pbharrin/dodo-bot/simulation/training/README.md

# Learned stand / step-in-place policy (stage 1)

Trains a 50 Hz joint-position policy for the [v5 model](../models/build_model_v5.py) with MuJoCo Playground, Brax PPO and MJX-Warp. Each episode is either **stand** (25%) or **step in place** following a two-foot gait clock (75%). The base-velocity command is zero, so a good policy marches on the spot without drifting and recovers from pushes.

Stage 1 is meant to replace the quasi-static two-foot-to-one-foot work. Stepping in place includes weight transfer and single support, but done dynamically.

| File | Purpose |
| --- | --- |
| `dodo_env.py` | `DodoStepInPlace` environment, rewards, observations, domain randomization |
| `train_ppo.py` | PPO training, checkpoints, final evaluation and videos |
| `evaluate.py` | Reload a run, run deterministic rollouts, write `eval.json` and videos |
| `render_backend.py` | Picks EGL for headless video, or falls back to no rendering if the GL libraries are missing |
| `replay_mujoco.py` | Replays a policy in plain C MuJoCo under harsher conditions: full solver, smaller timestep, latency, lower torque limits |
| `warm_start.py` | Starts stage 2 from the stage-1 policy, adapting the command inputs |
| `test_dodo_env.py` | Pre-flight checks: model mass/geometry, MJX vs MuJoCo, passive standing, gait clock, randomization |

## Status

- **CPU-validated (JAX backend, Apple M2):** all tests pass, the full train → save → evaluate → render pipeline runs, and the zero-action robot stands for 4 s. See "Validation" below for a short CPU learning-signal run.
- **GPU-validated (MJX-Warp, g5.xlarge A10G, 2026-11-02):** all 6 tests (the 7th, a config check, was added afterwards) pass with `DODO_TEST_IMPL=warp`. A 10M-step trial ran at about 35k steps/s. Eval: 100% survival over 20 s with pushes in all 64 episodes, but stepping contact match 0.61 (the never-lift baseline is 0.60) and peak foot height about 1 cm. It learned to stand, not to step.
- **Stage 1 trained (2026-11-02):** 150M steps on the g5.xlarge in 41 min. The policy stands and steps in place with 4 cm foot clearance and survives every evaluation episode with pushes. See "Stage 1 result" below. Not yet checked: C MuJoCo replay, rope compliance, measured actuator limits.
- **Stage 2 trained (2026-11-02):** `stage2_walk` walks, turns and sidesteps on command with 100% survival with pushes, but with a favoured-leg gait. **`stage2_sym`** (fine-tuned with a symmetry reward) fixes that and is the current best policy. See "Stage 2: walking" below.
- **Stage 2b trained (2026-11-02): `stage2_smooth` is the current best policy.** A 6 Hz action low-pass filter cuts knee/ankle torque saturation about 40× with equal or better walking. It falls once in 24 replay episodes at 40 ms latency (`stage2_sym`: none). See "Stage 2b".
- **C MuJoCo replay passed (2026-11-02):** `stage2_sym` keeps 100% survival in plain C MuJoCo with the full solver, a 2 ms timestep, up to 40 ms latency and torque limits down to 6 Nm. See "C MuJoCo replay check".
- **Torque measurement corrected (2026-11-02):** the stage-1 and `stage2_walk` torque tables below sampled torque at the end of each 20 ms control step and miss brief PD-servo spikes right after each new target. p95 and RMS there are fine; their max / saturation numbers understate the peaks. See "Torque spikes from position-target steps".

## Stage 1 result (2026-11-02)

Run `stage1_v5`: 150M env steps, 8192 envs, MJX-Warp on a g5.xlarge (A10G), domain randomization on, default config. Training took 2434 s (about 62k steps/s) plus 46 s of JIT. The run directory isn't in git (`simulation/results/local/` is ignored).

**Learning curve.** Episodes reached the full 20 s by 10M steps. Contact match rose through about 45M steps and then plateaued at about 0.86. Reward plateaued at about 117. More steps at this config are unlikely to help.

| Steps | Eval reward | Episode length | Contact match (all episodes) |
| ---: | ---: | ---: | ---: |
| 0 | -1.0 | 45 | 0.52 |
| 10.8M | 99.8 | 1000 | 0.74 |
| 21.6M | 111.5 | 1000 | 0.82 |
| 43.3M | 115.5 | 1000 | 0.85 |
| 86.5M | 117.0 | 1000 | 0.87 |
| 151.4M | 116.4 | 993 | 0.87 |

**Evaluation.** 64 deterministic 20 s episodes on the nominal model with sensor noise, pushes and random action delay. The figures are from `evaluate.py --impl jax` on a Mac; the GPU evaluation at the end of training gave the same picture (stepping contact match 0.84, foot height 4.2 cm, peak torque 10.0 Nm).

| | Stepping (47 episodes) | Standing (17 episodes) |
| --- | ---: | ---: |
| Survival over 20 s | 100% | 100% |
| Contact match (never-lift baseline 0.60) | 0.84 | 1.00 |
| Mean peak foot height (target 3–5 cm) | 4.2 cm | 0.9 cm |
| Base drift over 20 s | 20 cm | 1 cm |
| Peak joint torque | 9.3 Nm | 4.7 Nm |

**Joint torque while stepping** (N m, steady stepping, 38.8k control steps outside the 1 s after a push):

| Joint | Left p95 | Left p99 | Left max | Left RMS | Right p95 | Right p99 | Right max | Right RMS |
| --- | ---: | ---: | ---: | ---: | ---: | ---: | ---: | ---: |
| hip yaw | 1.5 | 1.9 | 2.8 | 0.7 | 1.0 | 1.4 | 2.4 | 0.5 |
| hip roll | 4.8 | 5.7 | 7.0 | 2.4 | 4.5 | 5.1 | 8.6 | 2.5 |
| hip pitch | 1.4 | 2.3 | 3.7 | 0.7 | 1.5 | 2.0 | 3.6 | 0.8 |
| knee pitch | 4.8 | 5.9 | 8.0 | 2.5 | 3.2 | 4.1 | 5.8 | 1.8 |
| ankle pitch | 3.8 | 6.4 | 7.8 | 1.7 | 2.0 | 2.8 | 4.3 | 0.9 |

Findings:

- **No joint ever hits the 10 Nm limit** (0% of control steps saturated, stepping or standing). *Correction:* this table samples the end of each control step. Brief servo spikes in the first substep after a new target do reach 10 Nm; see "Torque spikes from position-target steps".
- **The torque comes from stepping itself, not from pushes.** The push-recovery table is nearly identical to the one above; it adds only the single highest peak (left ankle, 9.3 Nm). Single support needs it: hip roll, knee and ankle reach p95 of 4–5 Nm and p99 of up to 6.4 Nm on every gait cycle, with short peaks of 7–9 Nm. That matches the 6.7 Nm static hip-roll moment of the 6.84 kg model.
- **RMS is at most 2.5 Nm** (hip roll and knee). This is the number to compare with the measured continuous rating; peaks must fit the measured short-term rating (about 9 Nm ≈ 14 A at the plan's 0.625 Nm/A estimate).
- **The gait is asymmetric:** the left knee and ankle carry noticeably more torque than the right (p95 4.8 vs 3.2 Nm and 3.8 vs 2.0 Nm). No symmetry term is in the reward. Worth watching in videos and possibly penalizing.
- **Standing is cheap:** p95 below 2 Nm on every joint.
- **Drift of 20 cm in 20 s** while stepping: slow wandering rather than stepping on the spot. A candidate for a stronger base-velocity penalty in a later run.

Hardware implication for milestone 2: an actuator module that holds about 2.5 Nm continuous and about 9–10 Nm for short bursts covers this policy, with the masses currently estimated in the model. If the bench shows less, retrain with the measured limit; the policy will trade gait aggressiveness and push recovery for it.

## Stage 2: walking

The robot follows a base-velocity command: forward/back speed, sideways speed and yaw rate in the body frame, resampled every 10 s. `--task walk` applies `dodo_env.WALK_OVERRIDES`:

| Setting | Stage 1 | Stage 2 |
| --- | --- | --- |
| `lin_vel_x` (m/s) | 0 | −0.1 to 0.3 |
| `lin_vel_y` (m/s) | 0 | −0.1 to 0.1 |
| `ang_vel_yaw` (rad/s) | 0 | −0.5 to 0.5 |
| `zero_command_probability` (stepping segments told to step in place) | — | 0.2 |
| `stand_probability` | 0.25 | 0.15 |

Stand episodes always get a zero command. The speed ranges are ESTIMATES: 0.3 m/s is a slow walk for a 0.33 m leg (Froude number about 0.03). Gait clock, randomization and pushes are unchanged from stage 1. Since `stage2_walk` was trained, `WALK_OVERRIDES` also includes the symmetry reward (`reward_config.scales.symmetry=-4.0`; see "Left/right symmetry" below).

Run on the GPU machine, starting from the stage-1 policy:

```bash
python simulation/training/train_ppo.py --run-name stage2_walk --task walk \
    --warm-start simulation/results/local/train/stage1_v5 2>&1 | tee stage2.log
```

**Why `--warm-start` and not `--restore`:** stage 1 only ever saw a zero command, so its observation normalizer stores a std of 1e-6 for the command inputs. Restoring it unchanged would feed a 0.3 m/s command to the network as about 300,000. Because the normalizer averages over all 150M past steps, it would take a long time to correct. `warm_start.py` sets the command normalization to the stage-2 command distribution and zeroes the first-layer weights on the command inputs. Those weights never got any gradient in stage 1. The warm-started policy therefore starts out acting exactly like the stage-1 policy, whatever the command, and learns to use the command from there. (Checked: identical actions for zero and non-zero commands; the first eval of a smoke run already has stepping contact match 0.82, against 0.52 from scratch.) Only inputs that never varied in the source run are adapted. Warm-starting from a run that already saw commands, such as `stage2_walk`, keeps the policy exactly as trained (the script prints `adapted command inputs [False, False, False]`). Use `--restore` only to resume a run of the same task with the same rewards.

What to look for in `eval.json` (now also reported by `evaluate.py` for any run):

- `velocity_tracking.moving`: `lin_vel_error_mps` and `yaw_rate_error_radps`, plus commanded vs. actual mean speed. A policy that ignores the command shows actual speed near 0 and an error close to the commanded speed.
- `velocity_tracking.zero_command`: whether it still steps in place without wandering.
- Survival, contact match and the torque tables as in stage 1. Faster walking may raise knee and hip torque.

If it learns to stand or shuffle instead of walking, the usual fixes are a larger `tracking_lin_vel` scale or a narrower speed range to start, e.g. `--env-override lin_vel_x=[0,0.15]`.

### Stage 2 result: `stage2_walk` (2026-11-02)

150M steps, warm-started from `stage1_v5`, MJX-Warp on the g5.xlarge (about 40 min), no symmetry reward. GPU evaluation at the end of training: 64 episodes of 20 s with noise, pushes and action delay.

| | Stepping (52 episodes) | Standing (12 episodes) |
| --- | ---: | ---: |
| Survival over 20 s | 100% | 100% |
| Commanded / actual mean speed while moving | 0.146 / 0.132 m/s | — |
| Speed error while moving (ignoring the command would be about 0.15) | 0.067 m/s | — |
| Yaw-rate error while moving (commands up to ±0.5 rad/s) | 0.058 rad/s | — |
| Mean speed with zero command (includes step-to-step sway) | 0.052 m/s | 0.010 m/s |
| Contact match | 0.84 | 1.00 |
| Mean peak foot height | 4.2 cm | 0.9 cm |
| Peak joint torque | 10.0 Nm | 5.3 Nm |

Walking reaches about 90% of the commanded speed and tracks yaw well. The legs never cross in the videos.

**Torque while walking** (steady stepping, N m, compared with stage 1; end-of-control-step samples, see the correction in "Status"): p95 and RMS barely change. Hip roll p99 rises to 6.3 Nm (stage 1: 5.7), about the static single-support moment. The limit is touched only in rare spikes: left ankle 0.01% of control steps, right hip roll once. RMS stays at or below 2.5 Nm on every joint. The actuator target is unchanged from stage 1: about 2.5 Nm continuous, about 6.5 Nm p99 and brief 10 Nm peaks.

| Joint | Left p95 | Left p99 | Left max | Right p95 | Right p99 | Right max | RMS (L / R) |
| --- | ---: | ---: | ---: | ---: | ---: | ---: | ---: |
| hip yaw | 1.5 | 2.0 | 3.1 | 1.3 | 1.7 | 2.7 | 0.7 / 0.6 |
| hip roll | 4.9 | 6.3 | 8.9 | 4.8 | 5.5 | 10.0 | 2.4 / 2.5 |
| hip pitch | 1.7 | 2.3 | 4.6 | 1.7 | 2.2 | 3.4 | 0.8 / 0.9 |
| knee pitch | 4.1 | 5.0 | 6.9 | 3.5 | 4.6 | 7.5 | 2.3 / 1.9 |
| ankle pitch | 4.4 | 6.6 | 10.0 | 2.3 | 3.1 | 5.2 | 1.9 / 1.1 |

### Left/right symmetry

In the videos the left leg moves as if injured, without the right leg's range of motion. The model is exactly mirror-symmetric (checked: body positions, masses, inertias, joint axes, ranges and actuators; CoM on the midline), so this is a learned habit. Nothing in the stage-1 or stage-2 reward asked for symmetry, so the policy settled into a favoured-leg gait in stage 1, and stage 2 inherited it.

`evaluate.py` now measures this. Stepping episodes, re-evaluated with `--impl jax` (ROM = p95 − p5 joint angle in rad; mirror error = RMS of `right(t) − M·left(t − T/2)` and vice versa, where `M` flips hip yaw and roll):

| Joint | `stage1_v5` ROM L / R | `stage2_walk` ROM L / R | `stage2_walk` torque p95 L / R (N m) | `stage2_walk` mirror error (rad) |
| --- | ---: | ---: | ---: | ---: |
| hip yaw | 0.149 / 0.091 | 0.194 / 0.135 | 1.5 / 1.3 | 0.10 |
| hip roll | 0.086 / 0.146 | 0.119 / 0.144 | 4.9 / 4.8 | 0.05 |
| hip pitch | 0.202 / 0.177 | 0.252 / 0.262 | 1.7 / 1.7 | 0.10 |
| knee pitch | 0.402 / 0.354 | 0.419 / 0.401 | 4.1 / 3.5 | 0.11 |
| ankle pitch | 0.226 / 0.325 | 0.349 / 0.410 | 4.4 / 2.4 | 0.21 |

The left ankle uses 15–30% less range than the right while carrying nearly twice the torque, and its mirror error (about 0.2 rad, 11°) is twice that of any other joint. The left hip roll also moves less.

**Symmetry reward.** In a symmetric gait each leg repeats what the other did half a gait cycle earlier, mirrored. The env keeps the last 32 control steps of joint angles and, in stepping episodes, penalizes the squared error `|q_R(t) − M q_L(t − T/2)|² + |q_L(t) − M q_R(t − T/2)|²`, where T is taken from the gait clock. Pitch joints always count. Hip yaw and roll are weighted by `exp(−(v_y/0.03)² − (ω_z/0.1)²)`, because sideways and turning commands legitimately need asymmetric hip motion. Scale −4.0, about 5% of the per-step reward for the current gait. The penalty isn't in the critic's observation; the history is left out so the observation layout stays compatible with existing runs.

Fine-tune from `stage2_walk` on the g5 (about 40 min); this produced `stage2_sym`:

```bash
python simulation/training/train_ppo.py --run-name stage2_sym --task walk \
    --warm-start simulation/results/local/train/stage2_walk 2>&1 | tee stage2_sym.log
```

If a habit like this doesn't train out, retrain stages 1 and 2 from scratch with the symmetry reward on from the start (`--env-override reward_config.scales.symmetry=-4.0` for stage 1). A policy that is mirror-symmetric by construction is the stronger fallback.

### Stage 2 result: `stage2_sym` (2026-11-02)

150M steps warm-started from `stage2_walk` with the symmetry reward (scale −4.0). Evaluated on the Mac with `evaluate.py --impl jax` (64 episodes). In the videos the left leg no longer looks injured.

Mirror error (RMS rad) and ROM ratio, `stage2_walk` → `stage2_sym`:

| Joint | Mirror error, all stepping | Mirror error, straight commands | ROM ratio L/R |
| --- | --- | --- | --- |
| ankle pitch | 0.213 → **0.048** | 0.190 → 0.039 | 0.85 → 0.95 |
| knee pitch | 0.107 → 0.047 | 0.094 → 0.045 | 1.04 → 0.93 |
| hip pitch | 0.099 → 0.037 | 0.080 → 0.032 | 0.96 → 1.02 |
| hip roll | 0.049 → 0.045 | 0.035 → 0.027 | 0.82 → 0.92 |
| hip yaw | 0.101 → 0.087 | 0.073 → 0.038 | 1.44 → 1.50 |

Walking is unaffected or slightly better: 100% survival (64/64), stepping contact match 0.84, commanded / actual speed 0.151 / 0.147 m/s (98%), speed error 0.070 m/s, yaw-rate error 0.062 rad/s, peak foot height 4.3 cm.

Remaining asymmetries, neither blocking:

- **Left hip yaw moves about 50% more than the right** (ROM 0.17 vs 0.12 rad), but its straight-line mirror error is small (0.038). It comes from turning, where the yaw/roll symmetry penalty is faded out: the policy probably turns mostly with the left hip in both directions. Torques are small.
- **Left ankle torque at the end of each control step is higher** (p99 6.5 vs 3.8 Nm) although the angles now mirror. The reward compares angles only; foot loading or centre of pressure may still differ. Measuring left/right foot normal force and CoP would find the cause.

## C MuJoCo replay check

`replay_mujoco.py` runs a trained policy with plain `mujoco.MjData` / `mj_step` (no MJX), rebuilding the observation exactly as the env does (checked by a unit test). Every condition replays the same 24 episodes: start state, gait, commands, pushes and sensor noise are shared, on the nominal model. There is no random one-step delay; latency is set explicitly as a sensor-to-actuator delay in milliseconds. Results go to `<run>/replay_mujoco.json` (`replay_mujoco_override.json` with `--env-override`); `--video` renders one stepping episode per condition.

```bash
python simulation/training/replay_mujoco.py simulation/results/local/train/stage2_sym   # about 1.5 min on a Mac
```

`stage2_sym`, 24 episodes of 20 s each, all with pushes. By chance all 24 are stepping episodes (the stand share is 15%), so this set doesn't test standing; standing was already the easiest case in every evaluation.

| Condition | Solver iters | Timestep | Latency | Torque limit | Survival | Contact match | Speed err (m/s) | Yaw err (rad/s) | Saturated |
| --- | ---: | ---: | ---: | ---: | ---: | ---: | ---: | ---: | ---: |
| as trained | 2 | 4 ms | 0 | 10 Nm | 100% | 0.84 | 0.065 | 0.052 | 0.57% |
| full solver | 100 | 4 ms | 0 | 10 Nm | 100% | 0.84 | 0.065 | 0.052 | 0.57% |
| full solver, 2 ms | 100 | 2 ms | 0 | 10 Nm | 100% | 0.84 | 0.065 | 0.054 | 0.52% |
| latency 10 ms | 100 | 4 ms | 10 ms | 10 Nm | 100% | 0.82 | 0.067 | 0.052 | 0.58% |
| latency 20 ms | 100 | 4 ms | 20 ms | 10 Nm | 100% | 0.83 | 0.069 | 0.059 | 0.59% |
| latency 40 ms | 100 | 4 ms | 40 ms | 10 Nm | 100% | 0.82 | 0.078 | 0.086 | 0.56% |
| torque 8 Nm | 100 | 4 ms | 0 | 8 Nm | 100% | 0.84 | 0.065 | 0.052 | 1.44% |
| torque 6 Nm | 100 | 4 ms | 0 | 6 Nm | 100% | 0.84 | 0.065 | 0.053 | 3.82% |
| realistic | 100 | 2 ms | 10 ms | 8 Nm | 100% | 0.82 | 0.067 | 0.052 | 1.54% |

Saturated = share of joint × control-step samples whose peak over substeps reaches the limit.

Findings:

- **No dependence on MJX shortcuts:** the full solver and a halved timestep give the same results as training physics. The "solver iterations limit reached" warnings during training didn't teach the policy to exploit soft contacts.
- **Latency-tolerant:** 20 ms of constant delay costs almost nothing; 40 ms raises yaw-rate error by about 65% but nothing falls. The UNO Q → CAN → XDrive loop must stay well under 40 ms; under 20 ms gives margin.
- **The 10 Nm peaks aren't needed:** clipping torque at 6 Nm leaves survival, gait and tracking unchanged. The peaks are the servo spikes described next, not load the gait relies on.

Not covered yet: rope compliance and backlash, measured actuator torque-speed limits, a real current-loop model, encoder quantization, and the true masses. These need milestone-2 bench data.

## Torque spikes from position-target steps

The policy updates joint position targets every 20 ms, and the PD servo (kp = 30 Nm/rad) answers a target jump Δq with about 30·Δq Nm at once. A 0.33 rad jump is already 10 Nm. Replay instrumentation showed every saturated torque sample falls in the **first 4 ms substep after a new target**, none at the end of a control step. The env now records the peak over substeps (`info['peak_tau']`), and `evaluate.py` reports peak-based sat / p50–p99 / max, plus `p99 end` (end of control step) and RMS (time average, for heating).

`stage2_sym`, steady stepping, N m:

| Joint | Peak p95 | Peak p99 | Saturated (peak) | p99 end of step | RMS |
| --- | ---: | ---: | ---: | ---: | ---: |
| L / R hip yaw | 1.9 / 1.6 | 3.8 / 2.4 | 0% / 0% | 2.0 / 1.6 | 0.7 / 0.6 |
| L / R hip roll | 5.0 / 5.4 | 6.3 / 6.4 | 0% / 0.02% | 6.0 / 6.1 | 2.5 / 2.5 |
| L / R hip pitch | 2.3 / 2.7 | 3.4 / 3.8 | 0% / 0% | 2.3 / 2.2 | 0.8 / 0.9 |
| L / R knee pitch | 6.7 / 7.7 | 8.8 / 10.0 | 0.19% / 1.93% | 4.6 / 4.2 | 2.2 / 1.9 |
| L / R ankle pitch | 6.2 / 7.4 | 10.0 / 10.0 | 2.30% / 1.62% | 6.5 / 3.8 | 1.8 / 1.1 |

Hip roll's peak and end-of-step values agree: its load is sustained single-support load. The knee and ankle peaks are servo spikes on top of a much lower sustained load.

Implications:

- **Actuator sizing:** continuous about 2.5 Nm RMS, sustained p99 about 6.5 Nm (hip roll, ankle). The spikes can be clipped by the drive's current limit without harm (6 Nm replay above).
- **Capstan rope:** each spike is a load step on the rope: 10 Nm on a 40 mm radius is a 250 N tension change within milliseconds. Even if the motor can deliver it, the rope, anchors and tensioner would see it on most steps.
- **Fix being trained:** a low-pass action filter (next section). Linear interpolation of targets across the 20 ms was the alternative; the filter was chosen because it's the more common approach and needs nothing from the XDrive beyond 50 Hz position targets.

## Stage 2b: action low-pass filter

A first-order low-pass filter now sits between the policy and the joint targets: `a_f += α·(a − a_f)` every 20 ms, then `q* = q_home + 0.5 rad × a_f`. With `action_filter_hz = 6` Hz, α = 1 − exp(−2π·6·0.02) ≈ 0.53, so each target step is about half the raw action step. That leaves about 4× margin over the 1.0–1.5 Hz gait (about 14° phase lag at 1.5 Hz). The `action_rate` penalty doubles from −0.05 to −0.1 at the same time.

- **On hardware the UNO Q runs the same filter** on the policy output before sending targets over CAN, with the state starting at zero (home pose). The filter is part of the policy interface, like `action_scale`: a policy trained with it must run with it, and the reverse.
- **Observations are unchanged.** "Last action" is still the raw policy output, and the filter state isn't observed (the joint positions largely reveal it). So `--warm-start stage2_sym` loads directly and adapts nothing.
- **Defaults are off** (`action_filter_hz = 0`), so stage 1, `stage2_walk` and `stage2_sym` evaluate and replay exactly as before. `--task walk_smooth` applies `WALK_OVERRIDES` plus `SMOOTH_OVERRIDES`.

Run on the GPU machine (about 40 min for 150M steps):

```bash
python simulation/training/train_ppo.py --run-name stage2_smooth --task walk_smooth \
    --warm-start simulation/results/local/train/stage2_sym
python simulation/training/evaluate.py simulation/results/local/train/stage2_smooth
python simulation/training/replay_mujoco.py simulation/results/local/train/stage2_smooth
```

Zero-shot check (CPU, C MuJoCo replay, the same 8 stepping episodes): `stage2_sym` run with the 6 Hz filter it was never trained with.

| Condition | Filter | Survival | Contact match | Speed error m/s | Yaw error rad/s | Peak torque p99 Nm | Saturated |
| --- | --- | ---: | ---: | ---: | ---: | ---: | ---: |
| as trained | off | 100% | 0.84 | 0.065 | 0.051 | 10.0 | 0.54% |
| as trained | 6 Hz | 100% | 0.76 | 0.120 | 0.092 | 8.1 | 0.01% |
| 40 ms latency | off | 100% | 0.81 | 0.078 | 0.086 | 10.0 | 0.53% |
| 40 ms latency | 6 Hz | 100% | 0.76 | 0.125 | 0.124 | 8.0 | 0.00% |

The filter removes nearly all saturation even before retraining. Tracking and gait timing get worse because the policy doesn't expect the lag; the fine-tune should recover them. Success criteria for `stage2_smooth`: tracking and contact match back to `stage2_sym` levels, knee/ankle peak p99 well under 10 Nm, and 40 ms latency still survivable.

### Stage 2b result: `stage2_smooth` (2026-11-02), current best

150M steps warm-started from `stage2_sym` with `--task walk_smooth`, on the g5. Archived in `simulation/policies/stage2_smooth/` (weights, normalizer, config). Evaluated with `evaluate.py` (64 episodes) and `replay_mujoco.py` (24 episodes).

Torque, steady stepping, peak over substeps, `stage2_sym` → `stage2_smooth` (N m):

| Joint (L / R) | Peak p95 | Peak p99 | Saturated (peak) | p99 end of step | RMS |
| --- | --- | --- | --- | --- | --- |
| knee pitch | 6.7 / 7.7 → **5.3 / 5.8** | 8.8 / 10.0 → **6.3 / 7.3** | 0.19% / 1.93% → **0% / 0%** | 4.6 / 4.2 → 4.0 / 4.4 | 2.2 / 1.9 → 2.0 / 2.0 |
| ankle pitch | 6.2 / 7.4 → **4.9 / 5.8** | 10.0 / 10.0 → **8.3 / 7.5** | 2.30% / 1.62% → **0.11% / 0.03%** | 6.5 / 3.8 → 5.6 / 4.3 | 1.8 / 1.1 → 1.6 / 1.2 |
| hip roll | 5.0 / 5.4 → 4.8 / 5.5 | 6.3 / 6.4 → 5.7 / 6.4 | 0% / 0.02% → 0% / 0% | 6.0 / 6.1 → 5.6 / 6.2 | 2.5 / 2.5 → 2.3 / 2.5 |
| hip pitch | 2.3 / 2.7 → 2.5 / 2.1 | 3.4 / 3.8 → 3.5 / 2.6 | 0% | 2.3 / 2.2 → 2.4 / 2.2 | 0.8 / 0.9 → 0.8 / 0.9 |
| hip yaw | 1.9 / 1.6 → 1.8 / 1.5 | 3.8 / 2.4 → 3.5 / 2.1 | 0% | 2.0 / 1.6 → 1.9 / 1.7 | 0.7 / 0.6 → 0.6 / 0.5 |

Single control steps still reach 10 Nm on the knees, ankles and right hip roll, but rarely enough for the drive's current limit to clip them. Sustained loads (end of step, RMS) are unchanged: hip roll at about 6.4 Nm p99 is now the most loaded joint, and that is single-support load the filter can't remove. The left/right ankle end-of-step torque gap narrowed (6.5 / 3.8 → 5.6 / 4.3 Nm).

Walking, `evaluate.py`, 64 episodes, all survived:

| | `stage2_sym` | `stage2_smooth` |
| --- | ---: | ---: |
| Speed error, m/s | 0.070 | **0.066** |
| Yaw-rate error, rad/s | 0.062 | **0.052** |
| Commanded / actual speed, m/s | 0.151 / 0.147 | 0.151 / 0.148 |
| Stepping contact match | 0.836 | 0.818 |
| Peak foot height, cm | 4.3 | 4.4 |
| Hip yaw ROM ratio L/R | 1.50 | 1.28 |
| Ankle mirror error, all stepping, rad | 0.048 | 0.045 |

The fine-tune recovered all the tracking the filter cost the untrained policy (0.120 m/s in the zero-shot check) and then improved on `stage2_sym`. Contact match is about 2% lower, consistent with feet landing slightly later than the gait clock.

C MuJoCo replay, the same 24 episodes as for `stage2_sym` (stage2_sym values in brackets):

| Condition | Survival | Contact match | Speed err (m/s) | Yaw err (rad/s) | Peak p99 (Nm) | Saturated |
| --- | ---: | ---: | ---: | ---: | ---: | ---: |
| as trained | 100% | 0.82 (0.84) | 0.065 (0.065) | 0.048 (0.052) | 8.2 (10.0) | 0.01% (0.57%) |
| full solver | 100% | 0.82 (0.84) | 0.065 (0.065) | 0.048 (0.052) | 8.2 (10.0) | 0.01% (0.57%) |
| full solver, 2 ms | 100% | 0.82 (0.84) | 0.065 (0.065) | 0.049 (0.054) | 8.2 (10.0) | 0.01% (0.52%) |
| latency 10 ms | 100% | 0.81 (0.82) | 0.067 (0.067) | 0.048 (0.052) | 8.4 (10.0) | 0.01% (0.58%) |
| latency 20 ms | 100% | 0.81 (0.83) | 0.068 (0.069) | 0.056 (0.059) | 8.7 (10.0) | 0.01% (0.59%) |
| **latency 40 ms** | **96% (1 fall)** (100%) | 0.80 (0.82) | 0.079 (0.078) | 0.087 (0.086) | 9.3 (10.0) | 0.05% (0.56%) |
| torque 8 Nm | 100% | 0.82 (0.84) | 0.065 (0.065) | 0.048 (0.052) | 8.0 (8.0) | 0.17% (1.44%) |
| torque 6 Nm | 100% | 0.82 (0.84) | 0.065 (0.065) | 0.048 (0.053) | 6.0 (6.0) | 1.90% (3.82%) |
| realistic (2 ms, 10 ms latency, 8 Nm) | 100% | 0.81 (0.82) | 0.067 (0.067) | 0.047 (0.052) | 8.0 (8.0) | 0.21% (1.54%) |

- **Better wherever latency is 20 ms or less**, including the "realistic" condition, where saturation drops from 1.54% to 0.21%.
- **One fall at 40 ms.** The filter itself adds lag: its low-frequency group delay is (1 − α) / α × 20 ms ≈ 18 ms. So 40 ms of link latency means about 58 ms in total, beyond anything seen in training (a random 0 or 20 ms delay). One fall in 24 episodes is a small sample, but it's the first fall in any replay. The latency budget therefore matters more now: **keep the UNO Q → CAN → XDrive loop at or under 20 ms.**
- **If hardware latency turns out higher**, fine-tune with randomized latency up to 40 ms, in 4 ms substeps rather than whole 20 ms control steps.

## Validation (CPU, 2026-11-01)

Apple M2, JAX backend, 512 environments, about 3.9M steps, about 10 minutes. This checks for a learning signal; it is not a trained policy.

| Steps | Eval reward | Episode length (of 1000) |
| ---: | ---: | ---: |
| 0 | -1.05 | 45 |
| 1.3M | 2.38 | 122 |
| 2.6M | 30.0 | 609 |
| 3.9M | 63.0 | 965 |

Final deterministic eval, 64 episodes with pushes, noise and latency:

- Survival: 100% over 20 s.
- Base drift: 3 cm.
- Peak torque: 5.7 Nm.
- Stepping episodes: contact match 0.60, the score of a robot that **never lifts a foot**.

So, as expected, the policy learned to stand and absorb pushes first. Stepping has not emerged at this budget. On the GPU run, watch for stepping contact match to rise above 0.6 and peak foot height to approach 3–5 cm. If it stays stuck in "stand still" well past ~50M steps, try `--env-override stand_probability=0.0` and a larger `feet_phase` / `contact_match` scale.

## GPU machine setup

Tested on a **g5.xlarge** (1 × NVIDIA A10G 24 GB, 4 vCPU, 16 GiB RAM), Python 3.14. A g6e.xlarge (1 × L40S 48 GB, 32 GiB RAM) should be faster. 4 vCPUs are enough because the simulation runs on the GPU. If the GPU runs out of memory, use `--num-envs 4096`.

Measured on the g5.xlarge: about 35k env steps/s with 8192 envs (10M steps in 283 s plus 46 s of JIT), so the default 150M-step run takes about 70 min.

### Recommended: AWS Deep Learning Base OSS Nvidia Driver GPU AMI (Ubuntu 24.04)

This AMI ships the NVIDIA driver, so `nvidia-smi` works on first boot. [uv](https://docs.astral.sh/uv/) makes the venv and fetches Python 3.14 if needed (3.11–3.14 all work; the pinned requirements have binary wheels for each).

```bash
nvidia-smi                                   # GPU visible
curl -LsSf https://astral.sh/uv/install.sh | sh && source $HOME/.local/bin/env
git clone https://github.com/pbharrin/dodo-bot.git && cd dodo-bot
git checkout v5-policy-training
uv venv --python 3.14 .venv && source .venv/bin/activate
uv pip install -r simulation/training/requirements.txt "jax[cuda12]==0.9.2"
python -c "import jax; print(jax.devices())"   # expect [CudaDevice(id=0)]
```

If JAX complains about cuDNN/cuSPARSE versions, `unset LD_LIBRARY_PATH` (the AMI's own CUDA can shadow the pip-installed one). Use `uv pip install`, not `pip`, inside a uv venv.

### Fallback: plain Ubuntu AMI (tested on 26.04)

Plain Ubuntu has no NVIDIA driver (`nvidia-smi: command not found`, and JAX fails with `cuInit(0) failed: Unknown CUDA error 303`). Install the driver and reboot, then follow the steps above from `curl`:

```bash
sudo apt-get update
sudo apt-get install -y ubuntu-drivers-common
sudo ubuntu-drivers install --gpgpu nvidia:580-server
sudo reboot
```

### Video rendering (optional)

Videos need EGL/OpenGL system libraries. Without them, `import mujoco` fails with `'NoneType' object has no attribute 'eglQueryString'` or `... 'glGetError'`. To enable rendering:

```bash
sudo apt-get install -y libegl1 libegl-mesa0 libgl1 libopengl0 ffmpeg
sudo apt-get install -y libnvidia-gl-580-server   # optional, GPU rendering; must match the driver
```

You don't need them to train. `train_ppo.py` and `evaluate.py` check for EGL at startup; if it's missing they print a warning, set `MUJOCO_GL=disable` and skip videos. You can also set `MUJOCO_GL=disable` yourself. Render later on a Mac by copying the run directory back and running `python simulation/training/evaluate.py <run_dir> --impl jax`.

Pre-flight on the GPU, using both backends:

```bash
python -m unittest discover -s simulation/training -p test_dodo_env.py
DODO_TEST_IMPL=warp python -m unittest discover -s simulation/training -p test_dodo_env.py
```

Short GPU trial (about 10M steps, ~5 min on a g5) to check throughput and that reward climbs:

```bash
python simulation/training/train_ppo.py --run-name warp_trial --num-timesteps 10000000 --num-evals 5
```

Full stage-1 run (150M steps by default). Use `tmux` so the run survives an SSH disconnect:

```bash
tmux new -s train
python simulation/training/train_ppo.py --run-name stage1_v5
```

Results go to `simulation/results/local/train/<run-name>/` (git-ignored): `progress.csv`, `checkpoints/`, `params.pkl`, `eval.json` and `rollout*_step.mp4` / `rollout*_stand.mp4`. Copy back the run directory (not the checkpoints) with `scp -r` or `aws s3 cp --recursive`.

Useful flags:

- `--task walk` trains stage 2 (see above). `--warm-start <run_dir>` starts from that run's `params.pkl` with the command inputs adapted.
- `--restore <run>/checkpoints/<step>` resumes a run of the same task exactly.
- `--no-randomization` is a debugging baseline. If the policy can't learn without randomization, the rewards are the problem, not robustness.
- `--env-override KEY=JSON` changes env config without editing code, e.g. `stand_probability=0.0`, `push_config.enable=false`, `swing_height=[0.04,0.06]`, `lin_vel_x=[0,0.15]`.
- `--impl jax` runs on CPU or without Warp. It works but is much slower.
- `--env-override solver_iterations=4` (and `ls_iterations=…`) overrides the model's contact-solver iterations (default 2, from the XML). Warp prints `solver iterations limit reached - please increase iterations beyond 2` when a step doesn't converge. Occasional warnings are expected; if they appear constantly, raise it to 3–4 at some speed cost.

If Warp reports contact or constraint overflow, raise `naconmax` (total contacts across all worlds; each world uses up to 8 foot-floor contacts) or `njmax` (constraint rows per world) with `--env-override`.

## Reading a run

`progress.csv` / console:

- `len` (episode length, 1000 = 20 s without falling) should rise first.
- `contact_match` is the fraction of steps where each foot's contact state agrees with the gait clock. A policy that never lifts a foot still scores about 0.7: stand episodes match 100%, and standing through a stepping episode still matches the 60% stance portion of the clock. Only real stepping pushes it toward 1.0.

`eval.json` (from `evaluate.py`, nominal model with noise, pushes and latency) reports, separately for stepping and standing episodes:

- `survival_rate`
- `contact_match`
- `mean_peak_foot_height_m` (target swing clearance 3–5 cm)
- `base_drift_m` (should stay small for in-place stepping)
- `peak_joint_torque_Nm` (compare with the 10 Nm limit and, later, measured actuator limits)
- `velocity_tracking`: command-tracking error while commanded to move and while commanded zero (stage 2).
- `symmetry`: left vs. right range of motion, p95 torque and half-cycle mirror error while stepping (also printed as a table).
- `torque`: per joint, the fraction of control steps at the torque limit (`saturated_frac`, peak |τ| over the step's substeps ≥ 98% of limit), p50/p95/p99/max of that peak, `p99_end_of_step_Nm` and RMS (time average). It is split into `steady` and `push_recovery` (the 1 s after each push). Saturation during push recovery is acceptable. Saturation in `steady` stepping means the gait needs more torque than the actuator has. The same table prints to the console.

Probe specific conditions with `--env-override` (e.g. `push_config.enable=false`). Those results go to `eval_override.json`, so the training-time `eval.json` is kept.

**Watch the videos.** Reward can go up for degenerate reasons: shuffling, toe-dragging, or one foot vibrating. Common fixes: raise `feet_phase` or `contact_match` if the feet barely lift, raise `feet_slip` for shuffling, raise `action_rate` for jitter.

## Design choices and what to replace with hardware data

- **Action:** `q* = q_home + 0.5 rad × a` (or the low-pass-filtered `a` with `action_filter_hz`, stage 2b), with `a` tanh-bounded to [-1, 1], clamped to the joint range, and tracked by a joint-level PD servo (kp 30, kd 1, ±10 Nm). This is the "bounded joint-position targets with validated local gains" interface from the project plan. The real MKS XDrive position loop runs on the motor side through the capstan. Once a module is on the bench, identify its joint-level response and match `KP`/`KD` (or model it explicitly).
- **Observations:** the policy gets only what the robot will have: IMU gyro and gravity direction, joint encoders, the previous action and the gait clock. Base velocity, contacts and foot heights go only to the critic.
- **Sim-to-real randomization:** floor friction, link masses, torso mass (−0.3 to +0.8 kg) and CoM (±2 cm), armature, damping, friction loss, servo gains, torque limit, a one-control-step action delay on half the episodes, ±0.02 rad encoder offsets, sensor noise and base-velocity pushes.
- **Model estimates** (tagged `ESTIMATE` in `build_model_v5.py`) still need hardware data: 0.45 kg per actuator module, 1.6 kg torso, link masses, rotor inertia (→ 0.0096 kg m² armature), joint friction/damping, and where the knee and ankle motors sit. When modules are weighed and characterized (milestone 2), update the generator, regenerate, rerun the tests and retrain. Policies are tied to a model version.
- **Collision:** only feet touch the floor; leg-on-leg contact isn't simulated. The `feet_distance` reward keeps the feet at least 120 mm apart. Check the videos for leg crossing that CAD would forbid.
- **No ankle roll:** sideways balance must come from hip roll and foot placement, as on the planned hardware.

## Next stages

1. Stage 1 (this): stand and step in place, robust to pushes.
2. Stage 2 (set up, see above): walk forward slowly, sidestep and turn, warm-started from stage 1.
3. Before hardware: the C MuJoCo replay is done (above). Target smoothing is done (stage 2b, `stage2_smooth`). Next: measure the real UNO Q → CAN → XDrive latency (target ≤ 20 ms; see stage 2b), add measured actuator and rope models once bench data exists and replay again, then export the actor network for UNO Q inference. Keep joint ordering, units, gains, normalization statistics and action scaling identical.
