pbharrin/dodo-bot/cad/assemblies/dodo_v6_master.step

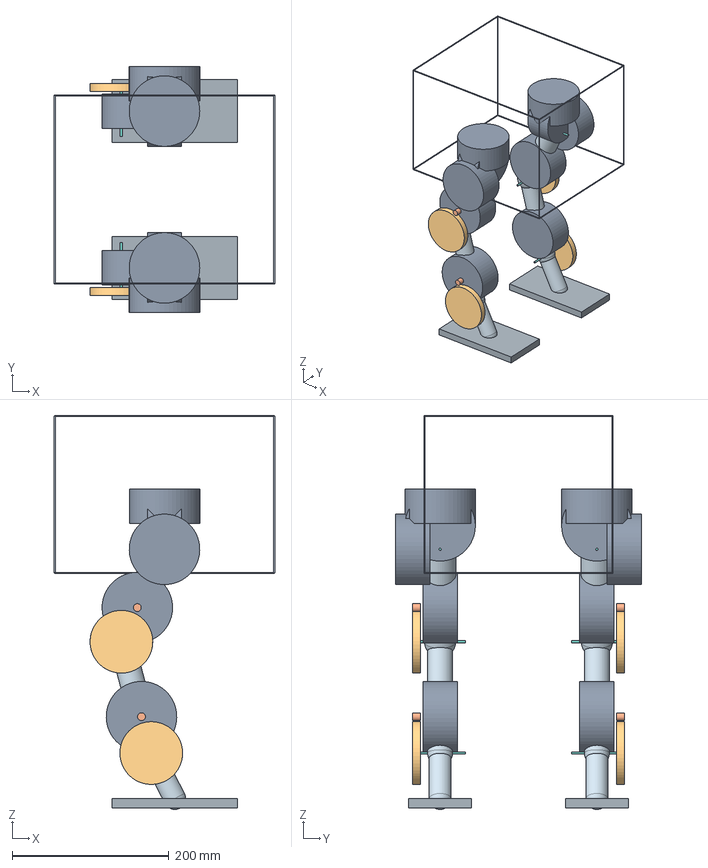
[picture p2: CAD file, 2026-11-05]
cad/assemblies/dodo_v6_master.step
281.4 x 314.0 x 502.5 mm
left_hip_yaw_module
right_hip_yaw_module
left_hip_roll_module
left_hip_pitch_module
left_thigh_geom
left_knee_module
left_shank_geom
left_ankle_module
left_hock_geom
left_foot
right_hip_roll_module
right_hip_pitch_module
right_thigh_geom
right_knee_module
right_shank_geom
right_ankle_module
right_hock_geom
right_foot
left_knee_pitch_output_drum
left_knee_pitch_input_drum
left_ankle_pitch_output_drum
left_ankle_pitch_input_drum
right_knee_pitch_output_drum
right_knee_pitch_input_drum
right_ankle_pitch_output_drum
right_ankle_pitch_input_drum
left_hip_yaw_axis
left_hip_roll_axis
left_hip_pitch_axis
left_knee_pitch_axis
left_ankle_pitch_axis
right_hip_yaw_axis
right_hip_roll_axis
right_hip_pitch_axis
right_knee_pitch_axis
right_ankle_pitch_axis
torso_cage_0_-1_-1
torso_cage_0_-1_1
torso_cage_0_1_-1
torso_cage_0_1_1
torso_cage_1_-1_-1
torso_cage_1_-1_1
torso_cage_1_1_-1
torso_cage_1_1_1
torso_cage_2_-1_-1
torso_cage_2_-1_1
torso_cage_2_1_-1
torso_cage_2_1_1
