pbharrin/dodo-bot/simulation/experiments/README.md

# Experiments

Store reproducible test scripts here (push tests, contact diagnostics, weight transfer, single-leg balance).
