pbharrin/dodo-bot/simulation/results/transition_v2/README.md

# Transition v2 validation

**The transition is still unsolved.** Active unloading changed the measured foot load, but the current heel-pivot path approached thigh contact before the release conditions were satisfied.

The final standalone script was run on the unchanged v4 model with default left-support settings. A control comparison used the same script with `--disable-active-unloading`. To avoid repeating the unchanged geometric search, the development comparison harness loaded the previously computed plan; its rock and lift `qpos` arrays were verified identical to the fresh standalone plan. This is marked `development_cached_plan` in the control JSON. The distributed script always plans normally.

| Final measurement | Active unloading | Feedback disabled |
| --- | ---: | ---: |
| Result | `BODY_CLEARANCE_LIMIT` | `PHASE_TIMEOUT_UNLOAD` |
| Simulation time | 9.934 s | 21.004 s |
| Swing-foot vertical load | 4.013 N | 4.331 N |
| Required swing load for release | below 1.015 N | below 1.015 N |
| Minimum checked body gap | 0.498 mm | 1.680 mm |
| Closest pair | left/right thigh | left/right thigh |
| COM support margin | -6.426 mm | -4.814 mm |
| Support-foot drift | 1.554 mm | 1.656 mm |
| Support-foot tilt | 0.327 degrees | 0.158 degrees |
| Peak logged motor torque over run | 2.292 Nm | 2.292 Nm |
| Unwanted active body contacts | 0 | 0 |
| Measured unloading / airborne verification | false / false | false / false |

These are termination-state comparisons at different times, not a claim of improved transition performance. The active run began unloading at 9.002 s with about 4.435 N on the swing foot. The run stopped at the default 0.5 mm clearance threshold, before the four-second force ramp could complete. Left hip yaw and right ankle pitch were at their limits; the signed margin fields show small MuJoCo soft-limit penetrations. Motor torque was not saturated.

One local posture update was attempted and rejected: it would have moved the COM approximately 0.885 mm opposite to the requested lateral direction and increased the COM residual. That candidate was never applied. This shows why accepting a pose based only on millimeter-scale IK tolerances is insufficient for very small feedback corrections.

## Diagnostics verified

Five automated regression checks passed:

- Measured force and COM margin prevent an invalid release, even when predicted swing force is zero.
- Force feedback remains bounded without integrator windup at its lower limit.
- Posture requests mirror with the support side; failed requests freeze integration and do not reset simulated state.
- Signed collision-distance gradients agree with finite differences both outside contact and during penetration.
- The independent LP diagnostic identifies an intentionally infeasible constraint set.

Earlier development trials with the old gradient reached tiny thigh penetrations and reported QP infeasibility. A finite-difference check exposed a reversed signed-distance gradient during penetration, which is corrected in this version. Optional soft-contact trials did not establish a successful transition. The final defaults retain rigid contact constraints and stop before contact.

Validation environment: Python 3.12, MuJoCo 3.17.0, OSQP 1.1.3, NumPy 2.3.5, SciPy 1.17.0. No full right-support validation or new video-rendering validation is claimed.

Model SHA-256 (unchanged in both runs):

```text
221a508b97a0a16b66a7dec9a6afc3cb43232b1873c3cc5a2b6a64424ab2ccd0
```

Validated script SHA-256:

```text
29601ea3f5c66a9c4ffc9807df3047a3f389b34107c5d25b0bdb2cc54036fb50
```

The JSON files retain parameters, plan, diagnostic timeline, posture decisions, and final state:

- [Active unloading](active_unloading.json)
- [Feedback disabled](control_disabled.json)

The full per-run CSVs are generated by the experiment and are not committed here. [Run instructions](../../experiments/TRANSITION_V2.md) write them to `simulation/results/local/`.

The next planning question is how to reach a release posture with adequate thigh clearance and joint range. These results establish a limitation of this tracked path and controller combination; they do not prove that the existing geometry cannot transition or that wider hips are necessary.
