pbharrin/dodo-bot/simulation/results/single_support_left/README.md

# Single-foot balance: successful baseline

The uploaded left-support run achieved `SUCCESS_BALANCE_ONLY`: ten continuous seconds meeting the measured balance thresholds, after approximately 34 ms of settling.

**Scope:** the robot is initialized in a searched one-foot pose at time zero. This result does not demonstrate transferring from two feet, push recovery, or walking. The subsequent transition experiment stalled while unloading; it is not this successful baseline.

## Files

- [Standalone experiment](../../experiments/dodo_single_support.py): pose search, static feasibility check, contact-aware inverse-dynamics QP, and measured success checks.
- [Exact tested floating model](../../models/dodo_floating.xml): generated from the existing v4 generator without geometry changes.
- [Original uploaded JSON summary](single_support_left.json): parameters, versions, pose, thresholds, and outcome.
- [Original uploaded CSV log](single_support_left.csv): measured trajectory and motor torques.

The JSON and CSV are preserved as uploaded. The CSV records selected simulation steps, not every integration step. The original summary did not record a controller hash; the accompanying controller is the retained experiment source from this session.

## Reproduce

From the repository root, with your Python virtual environment activated:

```bash
python -m pip install -r simulation/requirements.txt
python simulation/experiments/dodo_single_support.py \
  --model simulation/models/dodo_floating.xml \
  --mode balance --support left \
  --output simulation/results/local/single_support_left
```

A passing run exits with status 0 and reports `SUCCESS_BALANCE_ONLY` in the new JSON. Output goes to a separate directory to preserve the archived run.

The uploaded run used MuJoCo 3.17.0, OSQP 1.1.3, NumPy 2.5.4, and SciPy 1.18.1. Numerical details can vary across environments. To use the same MuJoCo and QP solver versions:

```bash
python -m pip install mujoco==3.17.0 osqp==1.1.3
```

For headless video on Ubuntu using CPU rendering:

```bash
sudo apt-get update
sudo apt-get install -y libosmesa6
MUJOCO_GL=osmesa PYOPENGL_PLATFORM=osmesa \
  python simulation/experiments/dodo_single_support.py \
  --model simulation/models/dodo_floating.xml \
  --mode balance --support left \
  --output simulation/results/local/single_support_left_video \
  --video simulation/results/local/single_support_left.mp4
```

## Recorded result

| Measurement | Uploaded run |
| --- | ---: |
| Continuous passing balance | 10.000 s |
| Total simulation time | 10.034 s |
| Final swing-foot clearance | 24.945 mm |
| Final swing-foot contact force | 0 N |
| Final swing-foot contacts | 0 |
| Final support-foot vertical force | 20.307 N |
| Peak logged motor torque | 3.1834 Nm |
| Motor torque limit | 4 Nm |
| Final support-foot drift | 0.0041 mm |
| Final support-foot tilt | 0.00217 degrees |
| Final unwanted contacts | 0 |

The full thresholds are in the JSON. Success requires actual airborne clearance, negligible swing-foot force, a loaded and stationary support foot, COM and CoP margins, low COM speed, torque reserve, and no unwanted contacts. No external supporting force is applied.

The original 2.07 kg model has 130 mm hip-center spacing and no ankle-roll joint. Model SHA-256:

```text
221a508b97a0a16b66a7dec9a6afc3cb43232b1873c3cc5a2b6a64424ab2ccd0
```

Regenerate the XML with `python simulation/models/build_model_v4.py`; this also generates the fixed-base model. The floating model generated by the repository's existing generator was checked against the recorded hash.

The optional `--mode transfer` and push arguments are exploratory tests, not established successful capabilities. The next research milestone is a measured two-foot-to-one-foot transition using the unchanged model.

## Repository packaging validation

Before this baseline was committed, the documented non-video command was rerun with MuJoCo 3.17.0, OSQP 1.1.3, NumPy 2.3.5, and SciPy 1.17.0. It exited 0 with `SUCCESS_BALANCE_ONLY` after ten continuous passing seconds. This fresh validation did not replace the original uploaded logs. Video rendering was not rerun as part of packaging.
