pbharrin/dodo-bot/simulation/results/README.md

# Results

Keep small selected CSV files and analysis notes. Document model version, controller settings, disturbance, and outcomes for reproducibility. Keep generated videos and large datasets out of Git.
