pbharrin/dodo-bot/simulation/results/release_test/comparison.csv

run | time_s | phase | path_fraction | governor_speed | governor_reasons | right_fz_N | right_predicted_fz_N | left_fz_N | left_predicted_fz_N | com_support_margin_m | com_tracking_error_m | max_joint_tracking_error_deg | worst_tracking_joint | left_drift_m | left_tilt_deg | minimum_body_clearance_m | peak_abs_tau_Nm | force_objective_enabled | release_blockers_all
contact_handoff | 0.002 | settle | 0.0 | 1.0 |  | 9.829513716616677 | 10.483570401873845 | 9.829513716626824 | 10.483570401883856 | -0.047000000000000056 | 1.5940359650019664e-06 | 0.002514140012187172 | left_knee_pitch | 3.092185222632049e-07 | 0.001351104550650007 | 0.05 | 0.48455715648657266 | 0 | swing_load|support_load|com_margin|path_complete
contact_handoff | 1.0020000000000007 | track_release | 4.628472299382716e-11 | 1.0 |  | 10.08512532764092 | 10.368210405374938 | 10.185059644134485 | 10.658631909184566 | -0.04699999813740381 | 0.0015544653478707098 | 7.664269569048298 | left_hip_pitch | 9.029485307043117e-06 | 0.05107408119007864 | 0.05 | 0.5633364179190463 | 0 | swing_load|support_load|com_margin|path_complete
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
