pbharrin/dodo-bot/simulation/results/single_support_left/single_support_left.csv

time_s | phase | support | success_now | success_streak_s | push_active | push_force_N | unwanted_contacts | left_fz_N | left_contacts | left_clearance_m | left_sole_speed_m_s | left_tilt_deg | left_cop_margin_m | left_drift_m | right_fz_N | right_contacts | right_clearance_m | right_sole_speed_m_s | right_tilt_deg | right_cop_margin_m | right_drift_m | com_x_m | com_vx_m_s | com_y_m | com_vy_m_s | com_z_m | com_vz_m_s | com_support_margin_m | com_speed_m_s | torso_z_m | left_hip_yaw_tau_Nm | left_hip_roll_tau_Nm | left_hip_pitch_tau_Nm | left_knee_pitch_tau_Nm | left_ankle_pitch_tau_Nm | right_hip_yaw_tau_Nm | right_hip_roll_tau_Nm | right_hip_pitch_tau_Nm | right_knee_pitch_tau_Nm | right_ankle_pitch_tau_Nm | peak_abs_tau_Nm | torque_utilization | qp_iterations | qp_violation | qp_solve_ms | left_predicted_fz_N | right_predicted_fz_N
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
