pbharrin/dodo-bot/(commit log)

2026-10-26 Document robot architecture, actuator validation, and CAD roadmap
2026-10-26 Record Eaglepower 8308 90 KV motor selection
2026-10-26 Resolve motor identity and update remaining design inputs
2026-10-27 Adopt MKS XDrive Mini candidate and document firmware and encoder constraints
2026-10-27 Correct leg architecture to five actuators per leg with hip pitch/yaw
2026-11-02 Add v5 model and stand/step-in-place policy training environment
    Move from quasi-static single-support control to dynamic policy training.
    - build_model_v5.py / dodo_v5.xml: project-plan geometry (200 mm hip
    spacing, 160x80 mm feet, 330 mm hips, 500 mm torso top), estimated
    actuator module masses (6.84 kg total), reflected rotor armature,
    PD position servos with 10 Nm limit, 120 deg joint windows,
    feet-only collision for MJX/Warp. v4 left unchanged.
    - training/: MuJoCo Playground env (stand or step in place on a gait
    clock), domain randomization, Brax PPO training script, evaluator,
    CPU pre-flight tests, and g6e.xlarge setup notes.
    CPU-validated only (JAX backend): tests pass;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
2026-11-02 Harden GPU setup: solver-iteration override, render fallback, AMI docs
    - dodo_env: solver_iterations / ls_iterations config overrides for the
    contact solver (default stays 2 from the model XML).
    - dodo_env: build a fresh default config per instance; the shared default
    argument let one env's overrides leak into later envs. Add a test.
    - render_backend: probe EGL before importing mujoco and fall back to
    MUJOCO_GL=disable with a warning, so missing GL libraries skip videos
    instead of stopping training. evaluate.py never loses stats to a
    rendering error.
    - README: Deep Learning Base GPU AMI + uv as the recommended setup, plain
    Ubuntu driver install as fallback, optional EGL/GL packag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
2026-11-02 Report per-joint torque saturation in policy evaluation
    evaluate.py now records per-joint actuator torque and reports, for stepping
    and standing episodes, the fraction of control steps at the torque limit
    (>= 98%) plus p50/p95/p99/max/RMS. Steps within 1 s of a push are reported
    separately as push recovery, so saturation that the gait itself needs can be
    told apart from saturation while recovering from pushes.
    Evaluations run with --env-override write eval_override.json instead of
    overwriting the training-time eval.json. Also ignore .venv/.
2026-11-02 Record stage-1 stand/step-in-place training result
    - simulation/training/README.md: stage-1 result for run stage1_v5 (150M
    steps, MJX-Warp on g5.xlarge, 41 min): learning curve, evaluation
    (100% survival, stepping contact match 0.84, 4.2 cm foot clearance),
    per-joint stepping torque (no saturation, p99 up to 6.4 Nm, peaks
    7-9 Nm, RMS <= 2.5 Nm), left/right asymmetry and drift findings, and
    the implied actuator requirement for milestone 2.
    - README.md: stage-1 stepping GIF.
2026-11-02 Set up stage-2 walking training warm-started from stage 1
    - dodo_env: WALK_OVERRIDES preset (vx -0.1..0.3 m/s, vy +-0.1 m/s,
    yaw +-0.5 rad/s, 20% zero-command stepping, 15% stand episodes);
    stand episodes always get a zero command.
    - warm_start.py: start a new stage from a run's params.pkl. Resets the
    observation normalizer for the command inputs (stage 1 stored std 1e-6)
    and zeroes their first-layer weights, so the policy starts identical to
    stage 1 and learns to use the command.
    - train_ppo: --task walk and --warm-start RUN_DIR.
    - evaluate: velocity-tracking stats; rebuild the env from the run's saved
    config (previously only impl was reused).
    - Tests for walk command sampling;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
2026-11-02 Add left/right symmetry measurement and reward; record stage-2 result
    - evaluate: per-joint left/right range of motion, p95 torque and
    half-cycle mirror error while stepping (printed and in eval.json).
    - dodo_env: symmetry reward penalizing right(t) - M left(t - T/2) and
    vice versa from a 32-step joint history; hip yaw/roll faded out for
    sideways/turning commands. Scale -4.0 in WALK_OVERRIDES, 0 for stage 1.
    - warm_start: only adapt command inputs that never varied in the source
    run, so warm-starting from stage2_walk keeps its command following.
    - Unit test for the symmetry error; README: stage-2 result (tracking,
    torque, favoured-leg finding with numbers) and stage2_sym fine-tune.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
2026-11-03 Add C MuJoCo replay check; measure peak substep torque; record stage2_sym
    - replay_mujoco.py: replay a policy in plain C MuJoCo (mj_step, no MJX)
    over a suite of conditions (full solver, 2 ms timestep, 10-40 ms
    latency, 8/6 Nm torque limits, combined) on identical episodes.
    stage2_sym survives all of them.
    - dodo_env: own substep loop (same physics as mjx_env.step) that records
    the peak |actuator force| over substeps in info['peak_tau'].
    - evaluate: torque saturation/percentiles from substep peaks; separate
    end-of-step p99 and time-average RMS. Previous tables sampled only the
    end of each control step and missed PD-servo spikes after target steps.
    - Unit test: replay observation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
2026-11-03 Add action low-pass filter and stage-2b walk_smooth task
    A first-order filter (action_filter_hz, off by default) between the policy
    output and joint targets, to remove PD-servo torque spikes on new targets.
    --task walk_smooth = walk + 6 Hz filter + doubled action_rate penalty,
    warm-started from stage2_sym. Replay applies the same filter and writes
    overrides to a separate file. Zero-shot replay of stage2_sym with the
    filter: saturation 0.54% -> 0.01%, tracking worse until fine-tuned.
2026-11-03 Record stage2_smooth (action low-pass filter) result
    Knee/ankle torque saturation down ~40x with equal or better tracking;
    one fall in 24 C MuJoCo replay episodes at 40 ms latency (filter adds
    ~18 ms lag), so the hardware loop must stay at or under 20 ms.
2026-11-04 Archive stage2_smooth policy in simulation/policies
    params.pkl (normalizer + actor + critic), config.json, eval/replay results
    and training curve for the current best policy, with a README covering
    lineage, model hash, the 50 Hz + 6 Hz filter interface and how to load it.
2026-11-04 Add model v6: knee and ankle motors at their joints
    v6 places the knee and ankle motors 48 mm above their joints (integrated
    capstan cartridge) instead of v5's 91/103 mm, raising swing-leg inertia
    about the hip ~31%. Env config gains a 'model' key (default v6); runs
    saved without it load as v5. stage2_smooth (trained on v5) runs on v6
    with torques within 3% per joint and 100% replay survival, so no retrain
    until bench data changes the estimates.
2026-11-04 Add v6 hip axis offset parameters and offset sweep; record independent hip pitch/yaw
    build_model_v6 gains HIP_ROLL_OFFSET / HIP_PITCH_OFFSET (default zero, so
    dodo_v6.xml is unchanged) and make_model_with() for variants.
    hip_offset_sweep.py runs a fixed policy on offset variants in C MuJoCo:
    roll-axis spacing costs ~0.6 Nm hip roll per 10 mm outboard, vertical
    stacking is nearly free. The sweep exposed a policy sensitivity to
    backward whole-body CoM shifts (12 mm -> 75% survival), outside the
    training randomization. Project plan: hip pitch and yaw are independent.
2026-11-04 Set up stage 2c: configurable torso CoM randomization and walk_com task
    torso_com_range config key (default +-2 cm, unchanged) feeds
    domain_randomize; --task walk_com widens fore/aft to +-5 cm (~+-18 mm
    whole-body) on model v6, warm-started from policies/stage2_smooth.
    hip_offset_sweep.py gains CoM-shift variants (--variants com) and a
    TORSO_COM_OFFSET generator parameter (zero in the committed model).
    README records the pre-training CoM sensitivity of stage2_smooth.
2026-11-04 Archive stage2_com as current best policy; record stage 2c and hip sweep rerun
    stage2_com: stage2_smooth fine-tuned on model v6 with torso CoM randomized
    ±5 cm fore/aft. 100% survival from 12 mm back to 20 mm forward whole-body
    CoM shift (stage2_smooth: 75% at 12 mm back) and in all replay conditions
    including 40 ms latency; nominal tracking unchanged. Hip offset sweep rerun
    with it: all variants survive, including legs 20 mm forward (was 67%);
    roll-axis spacing remains the costly dimension. hip_offset_sweep.py now
    defaults to stage2_com.
2026-11-04 Add simulation-derived design constraints and stage2_com GIF
    docs/project-plan.md section 8 gains a short list of CAD and hardware
    constraints from the v6 model and stage2_com policy (hip axis offsets,
    stance, CoM tolerance, knee/ankle cartridge, joint torque, latency), each
    linked to its evidence in the simulation READMEs. The top-level README
    shows the stage2_com walking GIF and records hip pitch/yaw as
    independently driven.
2026-11-04 Update GPU setup notes for the g6e.xlarge
    Recommend the g6e.xlarge (L40S 48 GB) for future training; record that all
    policies through stage2_com were trained on the g5.xlarge. Add a throughput
    table (g6e column to fill in), correct the full-run estimate to the measured
    ~41 min, advise keeping --num-envs 8192 for comparability with archived
    policies, and add a GPU identity check.
2026-11-05 Add v6 master skeleton CAD and hardware envelope study
